thinandcurious/eurorack-stm32-midi-to-cv/README.md

# MIDI to CV

## STLink Pins

- VDD (Do not connect)
- SWCLK
- GND
- SWDIO
- RST
- SWO
