thinandcurious/eurorack-stm32-midi-to-cv/hardware/pcb/Rev1 Export/MIDI to CV Rev1 schematics.pdf

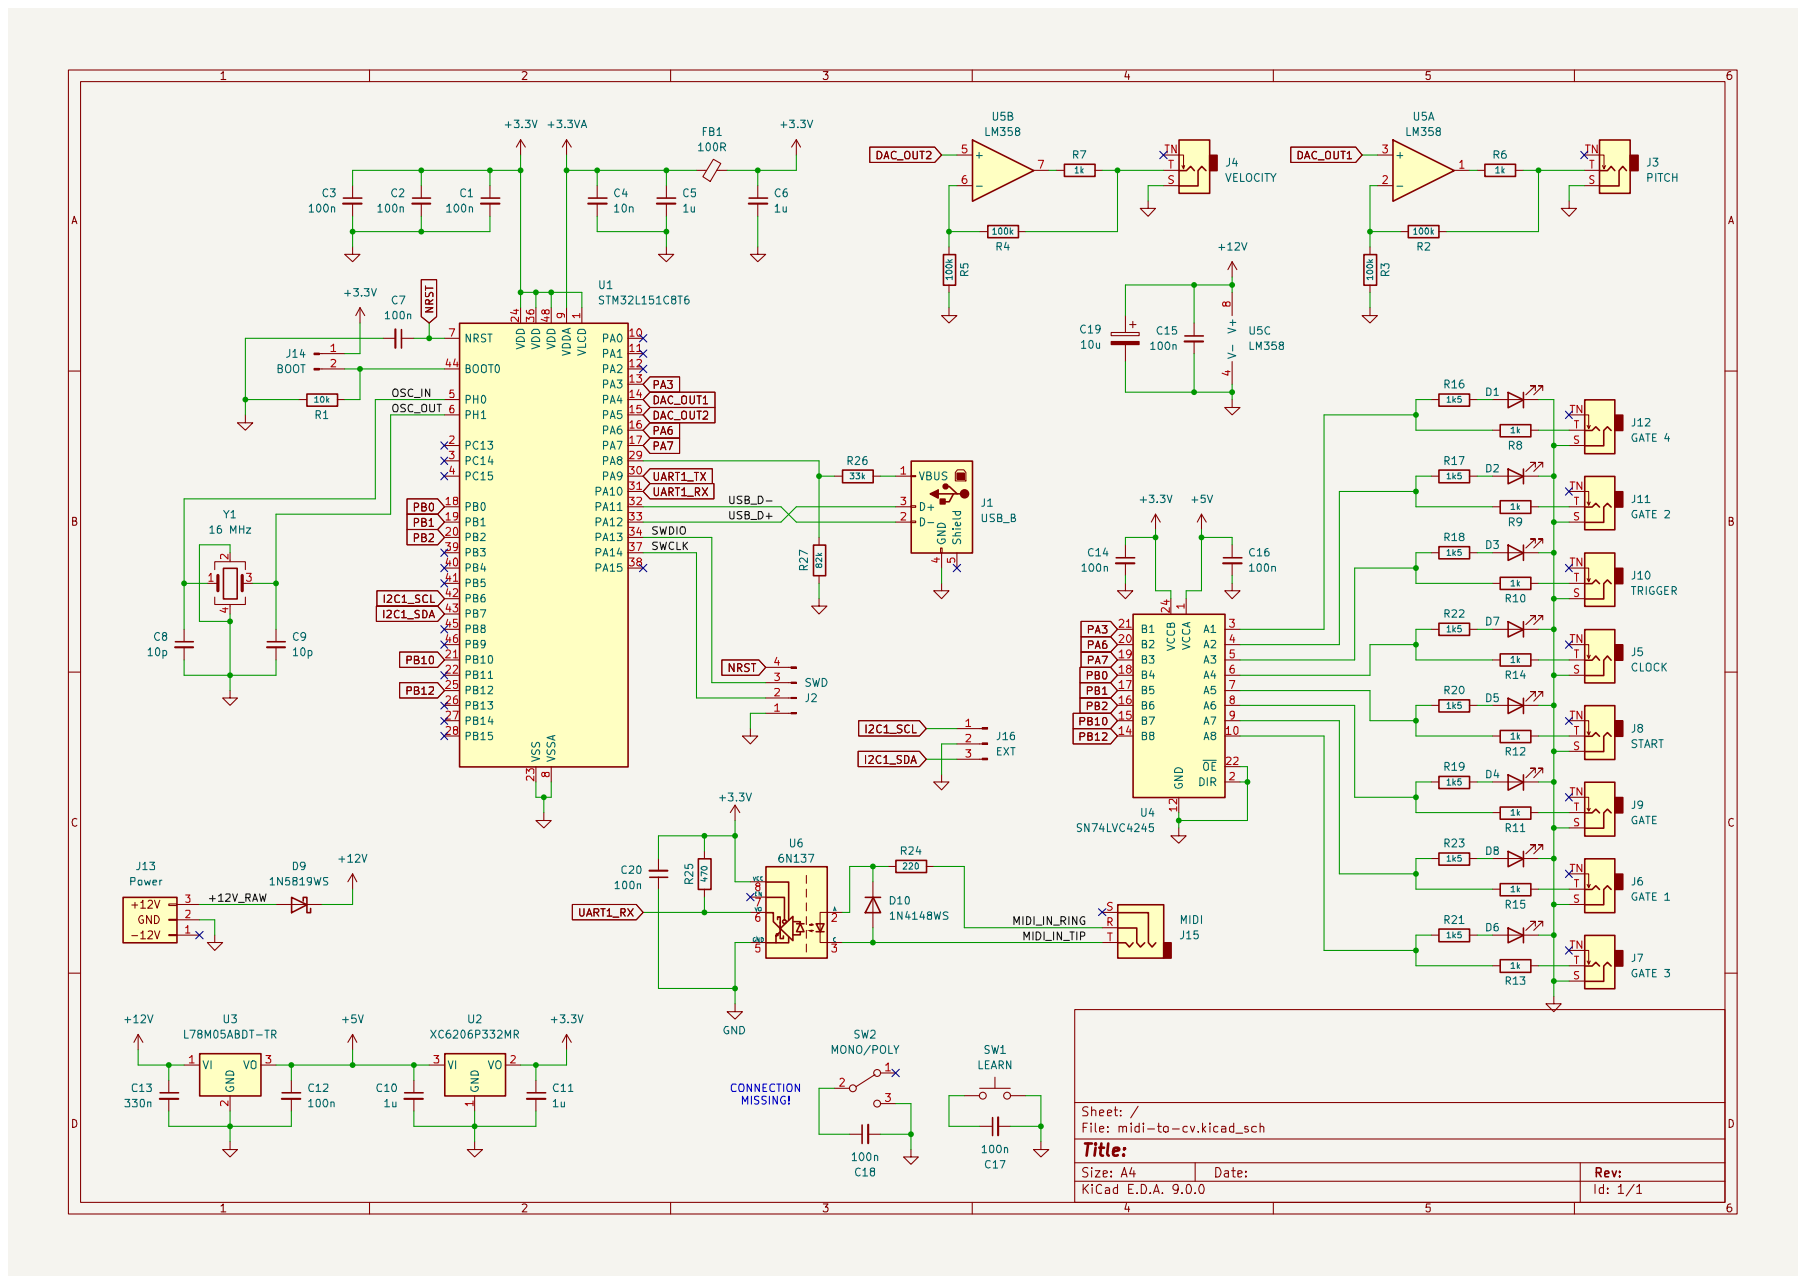
[picture p1: page 1]
