thinandcurious/eurorack-stm32-midi-to-cv/hardware/pcb/midi-to-cv.kicad_pcb

## KiCad design hardware/pcb/midi-to-cv.kicad_pcb (2025-03-17)

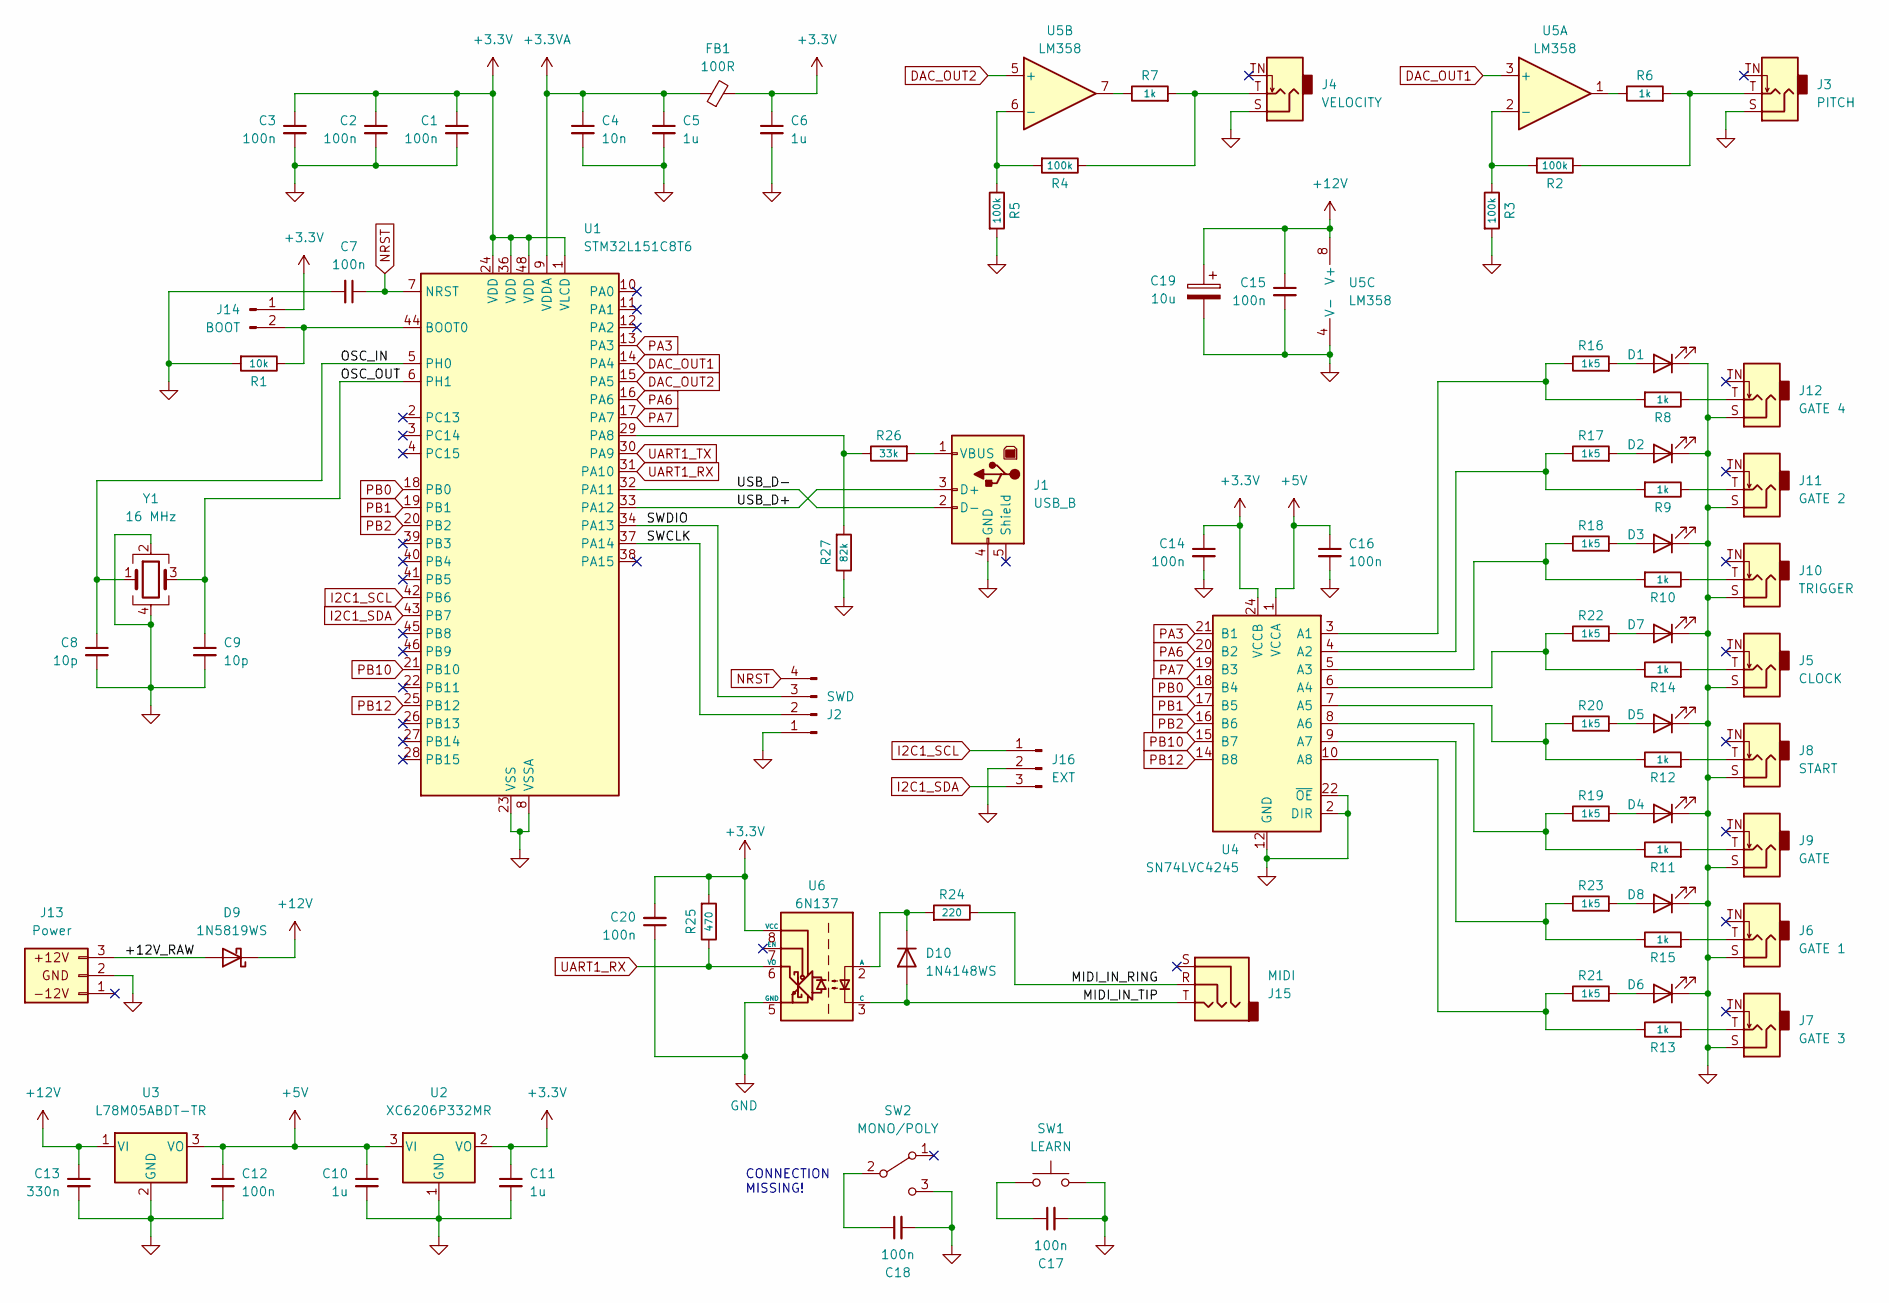
[picture p2: schematic midi-to-cv.kicad_sch]

Parts:
C1, C2, C3, C7, C14, C15, C16, C17, C18: 100n; C_0402_1005Metric; LCSC C307331
C4: 10n; C_0402_1005Metric; LCSC C15195
C5, C6, C10, C11: 1u; C_0805_2012Metric; LCSC C28323
C8, C9: 10p; C_0402_1005Metric; LCSC C32949
C12: 100n; C_0805_2012Metric; LCSC C49678
C13: 330n; C_0805_2012Metric; LCSC C1740
C19: 10u; C_1206_3216Metric; LCSC C13585
C20: 100n; C_0603_1608Metric; LCSC C14663
D1, D2, D3, D4, D5, D6, D7, D8: LED; LED_D3.0mm_Centered
D9: 1N5819WS; D_SOD-323; LCSC C191023
D10: 1N4148WS; D_SOD-323; LCSC 1N4148WS
FB1: 100R; L_0805_2012Metric; LCSC C1002
J1: USB_B; Reichelt_FIS-USB-2-B-180
J2: SWD; PinHeader_1x04_P2.54mm_Vertical
J3: PITCH; Jack_3.5mm_PJ398SM_Vertical
J4: VELOCITY; Jack_3.5mm_PJ398SM_Vertical
J5: CLOCK; Jack_3.5mm_PJ398SM_Vertical
J6: GATE 1; Jack_3.5mm_PJ398SM_Vertical
J7: GATE 3; Jack_3.5mm_PJ398SM_Vertical
J8: START; Jack_3.5mm_PJ398SM_Vertical
J9: GATE; Jack_3.5mm_PJ398SM_Vertical
J10: TRIGGER; Jack_3.5mm_PJ398SM_Vertical
J11: GATE 2; Jack_3.5mm_PJ398SM_Vertical
J12: GATE 4; Jack_3.5mm_PJ398SM_Vertical
J13: Power; JST_XH_B3B-XH-A_1x03_P2.50mm_Vertical
J14: BOOT; PinHeader_1x02_P2.54mm_Vertical
J15: MIDI; Jack_3.5mm_PJ366ST_Vertical
J16: EXT; PinHeader_1x03_P2.54mm_Vertical
R1: 10k; R_0603_1608Metric; LCSC C25804
R2, R3, R4, R5: 100k; R_0603_1608Metric; LCSC C25803
R6, R7, R8, R9, R10, R11, R12, R13, R14, R15: 1k; R_0603_1608Metric; LCSC C21190
R16, R17, R18, R19, R20, R21, R22, R23: 1k5; R_0603_1608Metric; LCSC C22843
R24: 220; R_0603_1608Metric; LCSC C22962
R25: 470; R_0603_1608Metric; LCSC C23179
R26: 33k; R_0603_1608Metric; LCSC C4216
R27: 82k; R_0603_1608Metric; LCSC C23254
SW1: LEARN; Switch_Push_6mm
SW2: MONO/POLY; Switch_SPDT_Micro-Toggle
U1: STM32L151C8T6; LQFP-48_7x7mm_P0.5mm; LCSC C9861
U2: XC6206P332MR; SOT-23-3; LCSC C5446
U3: L78M05ABDT-TR; TO-252-2; LCSC C58069
U4: SN74LVC4245; TSSOP-24_4.4x7.8mm_P0.65mm; LCSC C7859
U5: LM358; SOIC-8_3.9x4.9mm_P1.27mm; LCSC C7950
U6: 6N137; SSO-8_6.7x9.8mm_P2.54mm_Clearance8mm; LCSC C110020
Y1: 16 MHz; Crystal_SMD_3225-4Pin_3.2x2.5mm; LCSC C13738

Connections:
+3.3V: C1.1, C2.1, C3.1, C6.1, C11.1, C14.1, C20.2, FB1.2, J14.1, R25.2, U1.1 (VLCD), U1.24 (VDD), U1.36 (VDD), U1.48 (VDD), U2.2 (VO), U4.23 (VCCB), U4.24 (VCCB), U6.8 (VCC)
+3.3VA: C4.1, C5.1, FB1.1, U1.9 (VDDA)
+5V: C10.1, C12.1, C16.1, U2.3 (VI), U3.3 (VO), U4.1 (VCCA)
+12V: C13.1, C15.1, C19.1, D9.1 (K), U3.1 (VI), U5.8 (V+)
/+12V_RAW: D9.2 (A), J13.3
/MIDI_IN_RING: J15.R, R24.1
/MIDI_IN_TIP: D10.2 (A), J15.T, U6.3 (C)
/OSC_IN: C8.1, U1.5 (PH0), Y1.1
/OSC_OUT: C9.1, U1.6 (PH1), Y1.3
/SWCLK: J2.2, U1.37 (PA14)
/SWDIO: J2.3, U1.34 (PA13)
/USB_D+: J1.3 (D+), U1.33 (PA12)
/USB_D-: J1.2 (D-), U1.32 (PA11)
DAC_OUT1: U1.14 (PA4), U5.3 (+)
DAC_OUT2: U1.15 (PA5), U5.5 (+)
GND: C1.2, C2.2, C3.2, C4.2, C5.2, C6.2, C7.2, C8.2, C9.2, C10.2, C11.2, C12.2, C13.2, C14.2, C15.2, C16.2, C17.2, C18.2, C19.2, C20.1, D1.1 (K), D2.1 (K), D3.1 (K), D4.1 (K), D5.1 (K), D6.1 (K), D7.1 (K), D8.1 (K), J1.4 (GND), J2.1, J3.S, J4.S, J5.S, J6.S, J7.S, J8.S, J9.S, J10.S, J11.S, J12.S, J13.2, J16.2, R1.2, R3.2, R5.2, R27.1, SW1.2, SW2.3 (C), U1.8 (VSSA), U1.23 (VSS), U1.35 (VSS), U1.47 (VSS), U2.1 (GND), U3.2 (GND), U4.2 (DIR), U4.11 (GND), U4.12 (GND), U4.13 (GND), U4.22 (~OE), U5.4 (V-), U6.5 (GND), Y1.2, Y1.4
I2C1_SCL: J16.1, U1.42 (PB6)
I2C1_SDA: J16.3, U1.43 (PB7)
NRST: C7.1, J2.4, U1.7 (NRST)
unnamed: C17.1, SW1.1
unnamed: D1.2 (A), R16.2
unnamed: D2.2 (A), R17.2
unnamed: D3.2 (A), R18.2
unnamed: D4.2 (A), R19.2
unnamed: D5.2 (A), R20.2
unnamed: D6.2 (A), R21.2
unnamed: D7.2 (A), R22.2
unnamed: D8.2 (A), R23.2
unnamed: D10.1 (K), R24.2, U6.2 (A)
unnamed: J1.1 (VBUS), R26.2
unnamed: J3.T, R2.1, R6.2
unnamed: J4.T, R4.1, R7.2
unnamed: J5.T, R14.2
unnamed: J6.T, R15.2
unnamed: J7.T, R13.2
unnamed: J8.T, R12.2
unnamed: J9.T, R11.2
unnamed: J10.T, R10.1
unnamed: J11.T, R9.1
unnamed: J12.T, R8.1
unnamed: J14.2, R1.1, U1.44 (BOOT0)
unnamed: R6.1, U5.1
unnamed: R7.1, U5.7
unnamed: C18.1, SW2.2 (B)
unnamed: R26.1, R27.2, U1.29 (PA8)
unnamed: R8.2, R16.1, U4.3 (A1)
unnamed: R9.2, R17.1, U4.4 (A2)
unnamed: R10.2, R18.1, U4.5 (A3)
unnamed: R14.1, R22.1, U4.6 (A4)
unnamed: R12.1, R20.1, U4.7 (A5)
unnamed: R11.1, R19.1, U4.8 (A6)
unnamed: R15.1, R23.1, U4.9 (A7)
unnamed: R13.1, R21.1, U4.10 (A8)
unnamed: R2.2, R3.1, U5.2 (-)
unnamed: R4.2, R5.1, U5.6 (-)
PA3: U1.13 (PA3), U4.21 (B1)
PA6: U1.16 (PA6), U4.20 (B2)
PA7: U1.17 (PA7), U4.19 (B3)
PB0: U1.18 (PB0), U4.18 (B4)
PB1: U1.19 (PB1), U4.17 (B5)
PB2: U1.20 (PB2), U4.16 (B6)
PB10: U1.21 (PB10), U4.15 (B7)
PB12: U1.25 (PB12), U4.14 (B8)
UART1_RX: R25.1, U1.31 (PA10), U6.6 (VO)
UART1_TX: U1.30 (PA9)

Notes on the sheet:
CONNECTION MISSING!

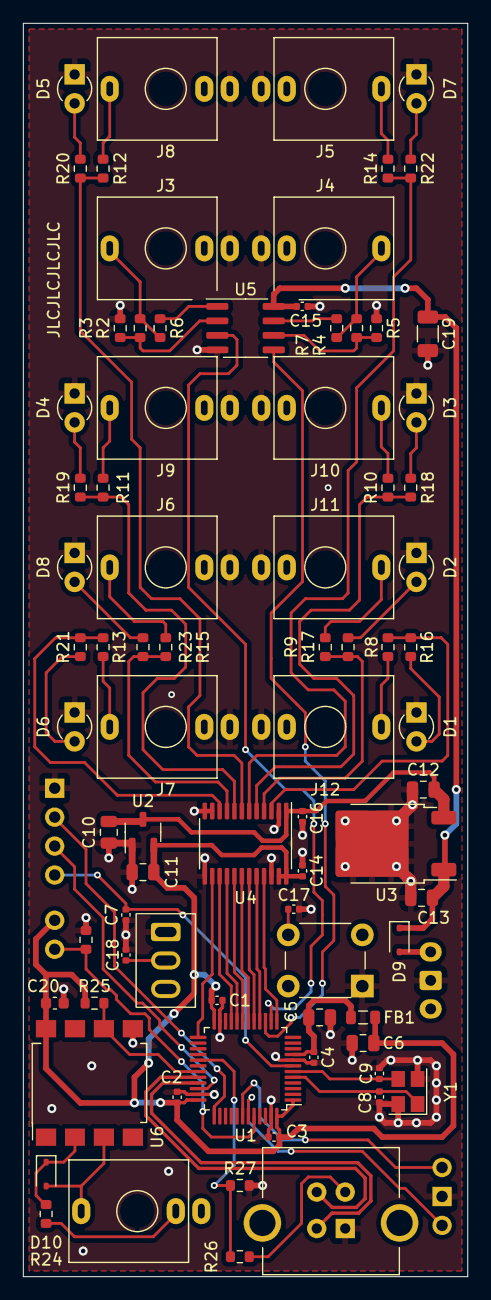
[picture p3: board midi-to-cv.kicad_pcb from above]

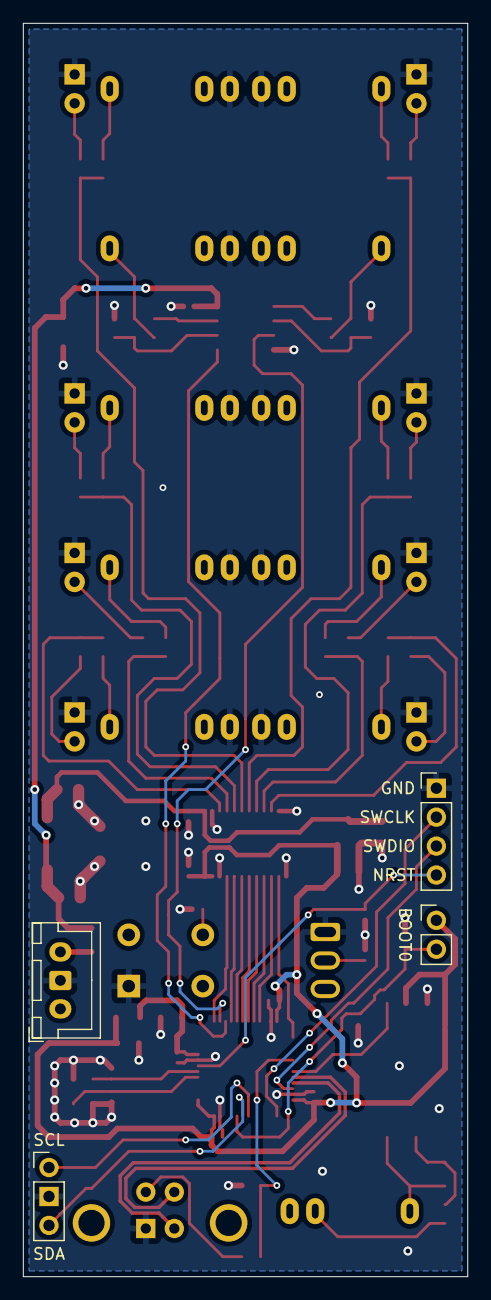
[picture p4: board midi-to-cv.kicad_pcb from below]

Board: 2 copper layers, 39.0 x 110.0 mm, 83 parts (4 on the bottom side), 64 nets.
