thinandcurious/eurorack-stm32-midi-to-cv/src/drivers/gpio.cpp

#include "gpio.h"

void MX_GPIO_Init(void) {
    GPIO_InitTypeDef GPIO_InitStruct = {0};

    /* GPIO Ports Clock Enable */
    __HAL_RCC_GPIOH_CLK_ENABLE();
    __HAL_RCC_GPIOA_CLK_ENABLE();
    __HAL_RCC_GPIOB_CLK_ENABLE();

    /*Configure GPIO pin Output Level */
    HAL_GPIO_WritePin(GPIOA, GATE4_Pin|GATE2_Pin|TRIGGER_Pin, GPIO_PIN_RESET);
    HAL_GPIO_WritePin(GPIOB, CLOCK_Pin|START_Pin|GATE_Pin|GATE1_Pin|GATE3_Pin, GPIO_PIN_RESET);

    GPIO_InitStruct.Pin = LEARN_Pin;
    GPIO_InitStruct.Mode = GPIO_MODE_IT_RISING_FALLING;
    GPIO_InitStruct.Pull = GPIO_PULLUP;
    HAL_GPIO_Init(LEARN_GPIO_Port, &GPIO_InitStruct);

    GPIO_InitStruct.Pin = GATE4_Pin|GATE2_Pin|TRIGGER_Pin;
    GPIO_InitStruct.Mode = GPIO_MODE_OUTPUT_PP;
    GPIO_InitStruct.Pull = GPIO_NOPULL;
    GPIO_InitStruct.Speed = GPIO_SPEED_FREQ_LOW;
    HAL_GPIO_Init(GPIOA, &GPIO_InitStruct);

    GPIO_InitStruct.Pin = CLOCK_Pin|START_Pin|GATE_Pin|GATE1_Pin|GATE3_Pin;
    GPIO_InitStruct.Mode = GPIO_MODE_OUTPUT_PP;
    GPIO_InitStruct.Pull = GPIO_NOPULL;
    GPIO_InitStruct.Speed = GPIO_SPEED_FREQ_LOW;
    HAL_GPIO_Init(GPIOB, &GPIO_InitStruct);

    GPIO_InitStruct.Pin = SWITCH_Pin;
    GPIO_InitStruct.Mode = GPIO_MODE_IT_RISING_FALLING;
    GPIO_InitStruct.Pull = GPIO_PULLUP;
    HAL_GPIO_Init(SWITCH_GPIO_Port, &GPIO_InitStruct);

    GPIO_InitStruct.Pin = USB_SENSE_Pin;
    GPIO_InitStruct.Mode = GPIO_MODE_INPUT;
    GPIO_InitStruct.Pull = GPIO_NOPULL;
    HAL_GPIO_Init(USB_SENSE_GPIO_Port, &GPIO_InitStruct);

    // EXTI interrupt init
    HAL_NVIC_SetPriority(EXTI2_IRQn, 0, 0);
    HAL_NVIC_EnableIRQ(EXTI2_IRQn);

    HAL_NVIC_SetPriority(EXTI15_10_IRQn, 0, 0);
    HAL_NVIC_EnableIRQ(EXTI15_10_IRQn);
}
