thinandcurious/eurorack-stm32-midi-to-cv/src/drivers/timer.cpp

#include "timer.h"

TIM_HandleTypeDef htim2;
TIM_HandleTypeDef htim3;

void MX_TIM2_Init(void) {
    TIM_ClockConfigTypeDef sClockSourceConfig = {0};
    TIM_MasterConfigTypeDef sMasterConfig = {0};

    htim2.Instance = TIM2;
    htim2.Init.Prescaler = 16000 - 1;
    htim2.Init.CounterMode = TIM_COUNTERMODE_UP;
    htim2.Init.Period = 10 - 1;
    htim2.Init.ClockDivision = TIM_CLOCKDIVISION_DIV1;
    htim2.Init.AutoReloadPreload = TIM_AUTORELOAD_PRELOAD_DISABLE;
    if (HAL_TIM_Base_Init(&htim2) != HAL_OK) {
        Error_Handler();
    }
    sClockSourceConfig.ClockSource = TIM_CLOCKSOURCE_INTERNAL;
    if (HAL_TIM_ConfigClockSource(&htim2, &sClockSourceConfig) != HAL_OK) {
        Error_Handler();
    }
    sMasterConfig.MasterOutputTrigger = TIM_TRGO_UPDATE;
    sMasterConfig.MasterSlaveMode = TIM_MASTERSLAVEMODE_DISABLE;
    if (HAL_TIMEx_MasterConfigSynchronization(&htim2, &sMasterConfig) != HAL_OK) {
        Error_Handler();
    }
}

void MX_TIM3_Init(void) {
    TIM_ClockConfigTypeDef sClockSourceConfig = {0};
    TIM_MasterConfigTypeDef sMasterConfig = {0};

    htim3.Instance = TIM3;
    htim3.Init.Prescaler = 16000 - 1;
    htim3.Init.CounterMode = TIM_COUNTERMODE_UP;
    htim3.Init.Period = 10 - 1;
    htim3.Init.ClockDivision = TIM_CLOCKDIVISION_DIV1;
    htim3.Init.AutoReloadPreload = TIM_AUTORELOAD_PRELOAD_DISABLE;
    if (HAL_TIM_Base_Init(&htim3) != HAL_OK) {
        Error_Handler();
    }
    sClockSourceConfig.ClockSource = TIM_CLOCKSOURCE_INTERNAL;
    if (HAL_TIM_ConfigClockSource(&htim3, &sClockSourceConfig) != HAL_OK) {
        Error_Handler();
    }
    sMasterConfig.MasterOutputTrigger = TIM_TRGO_UPDATE;
    sMasterConfig.MasterSlaveMode = TIM_MASTERSLAVEMODE_DISABLE;
    if (HAL_TIMEx_MasterConfigSynchronization(&htim3, &sMasterConfig) != HAL_OK) {
        Error_Handler();
    }
}

void HAL_TIM_Base_MspInit(TIM_HandleTypeDef* tim_baseHandle) {
    if (tim_baseHandle->Instance == TIM2) {
        /* TIM2 clock enable */
        __HAL_RCC_TIM2_CLK_ENABLE();

        /* TIM2 interrupt Init */
        HAL_NVIC_SetPriority(TIM2_IRQn, 0, 0);
        HAL_NVIC_EnableIRQ(TIM2_IRQn);
    } else if (tim_baseHandle->Instance == TIM3) {
        /* TIM3 clock enable */
        __HAL_RCC_TIM3_CLK_ENABLE();

        /* TIM3 interrupt Init */
        HAL_NVIC_SetPriority(TIM3_IRQn, 0, 0);
        HAL_NVIC_EnableIRQ(TIM3_IRQn);
    }
}

void HAL_TIM_Base_MspDeInit(TIM_HandleTypeDef* tim_baseHandle) {
    if (tim_baseHandle->Instance == TIM2) {
        /* Peripheral clock disable */
        __HAL_RCC_TIM2_CLK_DISABLE();

        /* TIM2 interrupt Deinit */
        HAL_NVIC_DisableIRQ(TIM2_IRQn);
    } else if (tim_baseHandle->Instance == TIM3) {
        /* Peripheral clock disable */
        __HAL_RCC_TIM3_CLK_DISABLE();

        /* TIM3 interrupt Deinit */
        HAL_NVIC_DisableIRQ(TIM3_IRQn);
    }
}
